DrFlGd/GearBox/(commit log)

2026-10-29 Phase 1 core kit: OpenSCAD library, catalog and render tools
    Module 2 gears on a 20 mm grid riding on 608 bearings, with three pin
    styles (printed bayonet, M8 and M6 bolts into captive nuts), a quarter-turn
    cap, knobs, spacers, spline couplers, compound gears, interlocking tiles and
    a fit test coupon. Print profiles for PLA, PETG and ABS live in one table.
    Tools render every catalog part with the OpenSCAD WebAssembly build (Manifold
    backend) under Node, check sizes, and screenshot STLs with three.js; CI runs
    the same render on every push.
    Claude-Session: https://claude.ai/code/session_01EfvyU7TCWwGpMecZSiFesC
    [gearbox.scad]
2026-10-29 Add release workflow: render all profiles and publish STL zips on a tag
    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
2026-10-29 Add the web part generator (phase 2) (#4)
    Vite + React + TypeScript app under app/ that runs OpenSCAD (WASM, Manifold)
    in a Web Worker with the scad library and BOSL2 embedded at build time.
    Part picker and parameter form driven by catalog/parts.json, PLA/PETG/ABS
    profiles with per-key fit overrides, three.js viewer with a 20 mm grid and
    size readout, STL download plus 3MF and OBJ written in the browser, and kit
    zips. Deployed to GitHub Pages by .github/workflows/pages.yml.
    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
2026-10-29 Two sizes, flat-top tiles and a printable coupler (#5)
    * Two sizes, flat-top tiles and a printable coupler
    Printability is now the first rule for every part:
    - standard.scad carries two sizes: M2 (module 2, 20 mm grid, M8 bolts, 608
    bearings) and M1.5 (module 1.5, 15 mm grid, M6 bolts, 606 bearings). Same
    tooth counts, mesh rule and part names in both.
    - Tiles are a flat plate with plain holes; the captive nut pockets open on
    the underside, so the tile prints top face down with no supports. The
    printed bayonet pin, cap and sleeve are gone: the pin is the bolt.
    - The spline socket is replaced by six peg holes on every gear face and a
    coupler made of two identical flat half rings wi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
    [gearbox.scad]
2026-10-29 Phase 3: layout tester (#6)
    * Phase 3: layout tester
    A Layout mode in the app: a board of tiles on the grid, pins in sockets,
    gears stacked by level. The tester flags pairs that mesh or collide and
    gears that hit another pin's spacer or knob, solves the train from the
    marked input (speed and direction per gear, locked loops flagged),
    animates it with teeth interleaved, shows the ratio on hover, builds the
    bill of materials (printed parts, bolts by length, nuts, bearings), renders
    and zips the kit, and keeps the layout in a shareable link. Ships with the
    plan's 1:16 example.
    Claude-Session: https://claude.ai/code/session_01EfvyU7TCWwG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
2026-10-29 Layout: type the number of tiles across and down (up to 16) (#7)
    The tile-count dropdowns stopped at 6; larger layouts need more. They are
    now number inputs clamped to 1..16, so a board can go to 128x128 sockets.
    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
2026-10-29 Phase 4a: cranks, pointers, pulleys, links, ratchet, N20 motor (#8)
    New add-on parts in scad/lib/addons.scad and scad/lib/motor.scad:
    crank arm with press-fit post, handle and cap, pointer and dial knob,
    pulleys, link bars and joint post, ratchet wheel and pawl, N20 motor
    mount with a 20T pinion. All ride on the existing three interfaces
    (peg face, bolt pin with bearings, sockets). Max level raised to 4.
    Generator: new part kinds with flip option and kit zips (crank, motor,
    pointer, ratchet, linkage). Layout tester: pulleys with bands, ratchet
    and pawl direction check, crank-rocker linkages, pointer with dial,
    motor mounts with leg footprint, "Add-ons sampler" layout and bill of
    materials f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
    [gearbox.scad]
2026-10-29 Phase 4b: rail, carriages, cams, Geneva, escapement, spring, winch (#9)
    Parts (scad/lib/mechanisms.scad): slider rail with end tabs and dovetail
    ridge, carriage with a plug pocket, rack carriages, scotch yoke, slider
    post, eccentric/heart/snail cams and a follower, Geneva driver (40T with
    post and locking crescent) and 6/8 slot wheels, half and quarter gears,
    quick-return lever, 15 tooth escape wheel with a recoil anchor, spring
    gear and printed spiral spring, winch drum with flange and hook. 33 new
    catalog parts with expected sizes and nine kits.
    Layout tester: the new item kinds and a fixture model for rails and their
    carriages, with partner rules (follower-cam, wheel-driver, anchor-wheel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
    [gearbox.scad]
2026-10-29 Phase 4c: planetary set, bevel pair and worm bracket, NEMA 17, flywheel (#10)
    New drives in scad/lib/drives.scad:
    - Planetary set: 60T planet carrier with four posts, a 20T sun on the
    level above, 20T planets and a 60T ring gear whose legs bolt into the
    sockets four away on either side (sun in, carrier out, 4:1).
    - Shaft bracket: a bar bolted along a socket row with bearing housings at
    its ends; a bolt through them is a shaft at the middle of level 4.
    A bevel gear on a 20T or 40T spur drives the shaft's mate bevel; a worm
    on the shaft turns a 20T or 40T worm gear two or three rows out.
    - NEMA 17 motor mount with full-height arms to a 48 mm plate and a
    pinion with a 5 mm D bore.
    -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
    [gearbox.scad]
2026-10-29 v0.8.0: steel pin and screw joints, magnets, assembly renders (#11)
    - Gears join with three steel dowel pins; 30T and bigger gears also take
    three M3 screws and nuts through a printed joint ring (JRING).
    - Crank and pointer hub rings key with pressed pins; the crank post is a
    kit bolt (handle version with the SH handle spacer); printed posts end
    in a pin-keyed cap. CPL, POST and POSTH stay as legacy parts.
    - Magnetic gears MG12-MG24 and a magnetic face coupling (G40-MT, G40-MB,
    MAGB barrier); magnet pocket on the fit coupon.
    - Assembly part: every kit put together on its tiles, assembled or
    exploded, with the hardware drawn in steel grey and a kit contents list.
    - Layout tester: do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
    [gearbox.scad]
2026-10-29 Assembly print layout download; full renders only when parts change (#12)
    * Assembly download: kit parts laid out for printing
    The Assembly part's download now renders every printed part of the kit
    in its print orientation, flat on z = 0 and spaced apart on 220 mm
    plates, and saves a 3MF with one object per part (one build item per
    copy) or an STL of separate bodies. The assembled view is still there as
    a separate download, for looking at.
    * CI: full catalog render only when a part source changed
    The PR and main check always builds the app, but renders the whole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
2026-10-30 v0.9.0: M1 size (module 1, M5, 605) and solid tile tabs (#13)
    - Tile and coupon male dovetail keys started half the slot clearance
    off the tile edge, so slicers saw them as loose pieces. They now root
    0.6 mm into the tile: every tile renders as one solid.
    - New size M1: module 1, 10 mm grid, M5 bolts and nuts, 605 bearings,
    6 mm gears on an 8 mm level, 2 mm dowel pins, M3 x 10 joint screws,
    3 x 2 mm magnets. Size constants go through sz(m2, m15, m1).
    - On the 10 mm grid the M5 nut pockets alternate 30 degrees so
    neighbours keep a wall between them.
    - M1 20T gears (and P20 pulleys) are too small for the pin holes and get
    none; the layout tester flags joining them or putting a cran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
    [gearbox.scad]
2026-10-30 v0.10.0: pinless stacking experiments, hex sleeve and jaw gears (#14)
    * Hex sleeve: stack gears and levers on a hex tube without pins
    A printed hex tube turns on the pin's bolt on two small bearings (688, 686,
    685) with a core tube between their inner races. Hex-bore gears, spacers and
    a lever slide onto it and turn together. Adds the parts to the generator,
    the catalog and the app, and a hexsleeve kit with an assembly.
    * Jaw gears: a pinless jaw and pocket joint to test in M2
    JG20, JG30 and JG40 have three crescent jaws on top and matching pockets
    underneath, s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
    [gearbox.scad]
2026-10-31 Faster renders and a browser cache for rendered models (#16)
    The library files included each other, and include is textual, so every
    part parsed BOSL2 about 25 times: 15 of a part's 17 s. gearbox.scad now
    includes each file once; sample parts come out byte-identical, about 5x
    faster in the tools and the app.
    render-catalog.mjs renders on worker threads (one per core), and the
    release renders each profile in its own parallel job. The full PETG
    catalog (329 parts) now takes about 4 minutes instead of about 25.
    The web app keeps rendered models in IndexedDB, keyed by the defines and
    a hash of the embedded sources and engine version, so a part, kit or
    print plate opens at once unless its confi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
2026-10-31 Open the bolt hole through the Geneva driver's top (and compound gear, winch) (#15)
    The two bearing seats left a 1 mm solid floor between their ledges, so the
    bolt could not pass and the Geneva driver could not be secured on its pin.
    A shared double_bearing_seat() cuts the wall open at the ledge diameter in
    all three sizes.
    Claude-Session: https://claude.ai/code/session_01EfvyU6gN1KdT4w5HUpcYw1
2026-10-31 Tapered crescent jaws as the default gear joint, with a joint switch (#18)
    Every gear and stacking part joins on three tapered crescent jaws (20 degree flanks, about 0.1 mm a side) with matching pockets underneath; M2 and M1.5 from 20T, M1 from 30T. A joint switch (jaws / dowel pins / pins + screws: M3, M2.5, M2) runs through gearbox.scad, the app, kit zips, the print plate and the layout tester, with per-face overrides (flat top, groove, pins). Cranks and pointers key onto the jaws; catalog expects, kits and README updated.
    Claude-Session: https://claude.ai/code/session_01EfvyU7mmUJauPn9L7Sg3tA
    [fit-check.scad, gearbox.scad]
2026-10-31 Redesign the app: Kits tab, slimmer Parts list, Settings drawer (#19)
    The app opens on a new Kits tab: kits in folding groups, Assembled / Exploded / Print layout views (the print layout drawn on 220 mm beds), a clickable parts list, the hardware and one download box. Parts gets search, folding groups and preset chips in place of the 116-entry dropdown. A Settings drawer holds the print profile, gear joints, fits, rendering options and the legacy and test parts (coupon, coupler, legacy crank post, straight jaw gear, hex sleeve). Layout gets a Start from menu, folded rules and the same download box. Old links keep working.
    Claude-Sessio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
2026-10-31 Compound gears: run the upper teeth down to the lower gear, no unsupportable overhang (#20)
    The upper gear used to start 1 mm above the lower gear on a root-radius
    bridge, so every upper tooth overhung a 1 mm gap too thin for supports.
    Claude-Session: https://claude.ai/code/session_01EfvyU5cgi9xfJ41WYnriHk
2026-10-31 Layout tab shows the real printed parts; sharper 3D views (#21)
    * Sharper 3D views: smooth shading, studio lighting, shadows, involute Layout gears
    The views drew every triangle flat (flatShading) under three plain lights, so
    round surfaces looked faceted and the scene flat. Now:
    - creased normals: curved surfaces shade smooth, edges over 35 degrees stay sharp
    (area weighted, about 200 ms per 100k triangles)
    - shared studio look: room environment reflections, neutral tone mapping, a soft
    shadow-casting key light and a contact shadow on the ground
    - Layout tab gears get true involute flanks (20 degree pressure angle) on the
    same pitch, tip and root circles, smoother bores and round pa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
2026-10-31 Layout: real mounts, rails, bracket, ring and links; working rack, escapement and partial gear; sunk ring leg screws (#22)
    sa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
2026-10-31 Tile keys: tight fit with crush ribs; press-fit nut pockets (#23)
    Keys get their own key_clear fit (0.10 / 0.12 / 0.15 mm per side) and a crush rib down both tail flanks that flattens on the first assembly, so joined tiles have no play. Nut pockets are a press fit on three crush ribs by default (nut_fit = "press"); a rod down the bolt hole pushes the nut out; nut_fit = "slip" keeps the old pocket. The coupon gets the ribbed key and one press / one slip pocket.
    Claude-Session: https://claude.ai/code/session_01EfvyU9vBnwpmL5zc1Y13UP
    [gearbox.scad]
2026-10-31 Geneva driver: remove the collar at the base of the drive post (#24)
    The 1 mm collar served no purpose and caught the wheel's slots when the
    post leans with a little play. The post now rises straight off the gear face.
    Claude-Session: https://claude.ai/code/session_01EfvyUAA7hBgSpHdgvX9dkU
2026-10-31 Magnetic module plates (test): standalone mechanism bases that snap together (#25)
    MOD3, MOD5 and MOD7 are standalone n x n bases for one mechanism each that join edge to edge with disc magnets. A gear whose pitch circle touches the edge is a port; the centre of an odd plate takes a hub of n x 10 teeth touching all four edges. Every grid step of every edge has a north-out and a south-out magnet and a ridge and groove, so any edge mates any edge, turned and shifted by whole sockets. scad/module-check.scad checks two plates for interference.
    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
    [gearbox.scad, module-check.scad]
2026-11-01 Scotch yoke: solid frame wall around the slot (#26)
    * Scotch yoke: solid frame wall around the slot
    The slot's rounded ends ran right to the ends of the frame, so the wall
    there was zero and only 4 mm along the sides. The frame now keeps a
    YOKE_WALL (5 / 4.5 / 4 mm for M2 / M1.5 / M1) on all sides of the slot,
    with rounded outer corners. The layout tester's slot plate box follows.
    Claude-Session: https://claude.ai/code/session_01EfvyU73U11Dbqibti1hjfm
    * Catalog: expected sizes for the thicker yoke frame
    Claude-Session: https://claude.ai/code/session_01EfvyU73U11Dbqibti1hjfm
    --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
2026-11-01 Crank slider: run clear of the rail, tab knobs and carriage (#27)
    The crank slider kit collided through its stroke: the crank's 20T on level 1
    sat one socket past a 4-socket rail, so the gear cut into the rail end and a
    tab knob, the carriage ran into the gear, the crank arm swept through the tab
    knob, and the 4-hole link pushed the carriage 13 mm off the rail.
    - Kit: the crank goes on a 30T on level 2 (above the rail, carriage and tab
    knobs; a 20T cannot carry a crank in M1), three sockets past the end of a
    new RAIL7, with a new 7-hole link L7 and SLPOST-L2. The stroke stays on the
    rail and the post stays clear of the crank in M2, M1.5 and M1.
    - Crank: arm 1 mm lower and the boss 1 m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
2026-11-01 Yoke kit: 7 socket rail, reach 6, 30T crank gear (#29)
    Claude-Session: https://claude.ai/code/session_01EfvyU73U11Dbqibti1hjfm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
    [gearbox.scad]
2026-11-01 Cam follower: output post, band hole, kit with drive gear and band pin (#28)
    The follower's tail now carries an output post (a kit bolt from below, like a
    crank post) whose bearing sits one level above the follower, so a link takes
    the rocking on. A hole beside the post takes the rubber band, which runs to a
    pin two sockets behind the follower and one over.
    The cam kit now shows how it is used: the cam pinned to a 30T (G30-PT, pin
    holes on top) that turns it, the follower, the band pin and the band. The
    layout tester checks the longer tail and the post for collisions, warns when a
    snail cam turns counter-clockwise into its step, and lists the band and the
    post hardware.
    Claude-Session: ht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
2026-11-01 Geneva: remove the lock's base lip, trim the wheel clear of the driver's top bearing (#30)
    - geneva_driver: the lock crescent now rises straight off the gear face. The
    1 mm full disc under it (the lip) caught a leaning wheel.
    - geneva_wheel: the rim stops at C - bearing OD/2 - 1.2 (gen_rim) instead of b,
    so the slot mouths swing past the driver's top bearing, which sits on the
    wheel's level. The old rim reached 8 / 6 / 4 mm from the driver's axis and ran
    into the bearing in every size. A small flare at each slot mouth guides the
    post in (the wheel is within about a degree of where the full rim would hold it).
    - 8 slots is now refused in M1: its lock disc is smaller than the top bea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
2026-11-01 Crank: arm raised over neighbouring jaws, shorter hand crank, prints flat (#31)
    The crank arm ran on its gear's top face, so it swept through the jaws of a
    neighbour's gear on the same level (every gear from the Parts tab and the
    release zips has jaws on top), and the hand crank kit's 60 mm throw reached
    well past its gear.
    - Crank: the arm's underside sits 0.5 mm over the jaw tops (5 / 4.5 / 4.5 mm
    above the gear) and its top 0.5 mm under a link two levels up. A collar round
    the knob stands the arm's full height and carries the jaw sockets (or the hub
    pins), so the crank prints arm top down with no support. The old print
    orientation stood on the 2 mm post boss with the arm hanging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
    [fit-check.scad, gearbox.scad]
2026-11-01 Shaft bracket: bevel on a 40T sits three sockets back, tester catches the housing hit (#32)
    The bevel pin's 40T spur reaches 2 * GRID + MOD from its pin, so two sockets
    before the bracket its teeth ran 6 mm (M2) into the first housing and bar in
    every size. The shaft kit and the drives sampler both used that layout.
    - bevel_shaft(reach): the hub reaches back 2 or 3 sockets; BEVEL-S3 is the
    3-socket mate for BEVEL40 (gearbox.scad param bevel_reach). BEVEL with its
    20T spur still sits two sockets back with BEVEL-S.
    - Shaft kit: BEVEL40 three sockets before the bracket, BEVEL-S3, worm gear
    moved with the bracket. The shaft bolt runs on through the long hub:
    M8 x 120 / M6 x 90 / M5 x 60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
    [gearbox.scad]
